htarold/uw-acoustic-modem-dtmf/dtmf-pll.sch.png

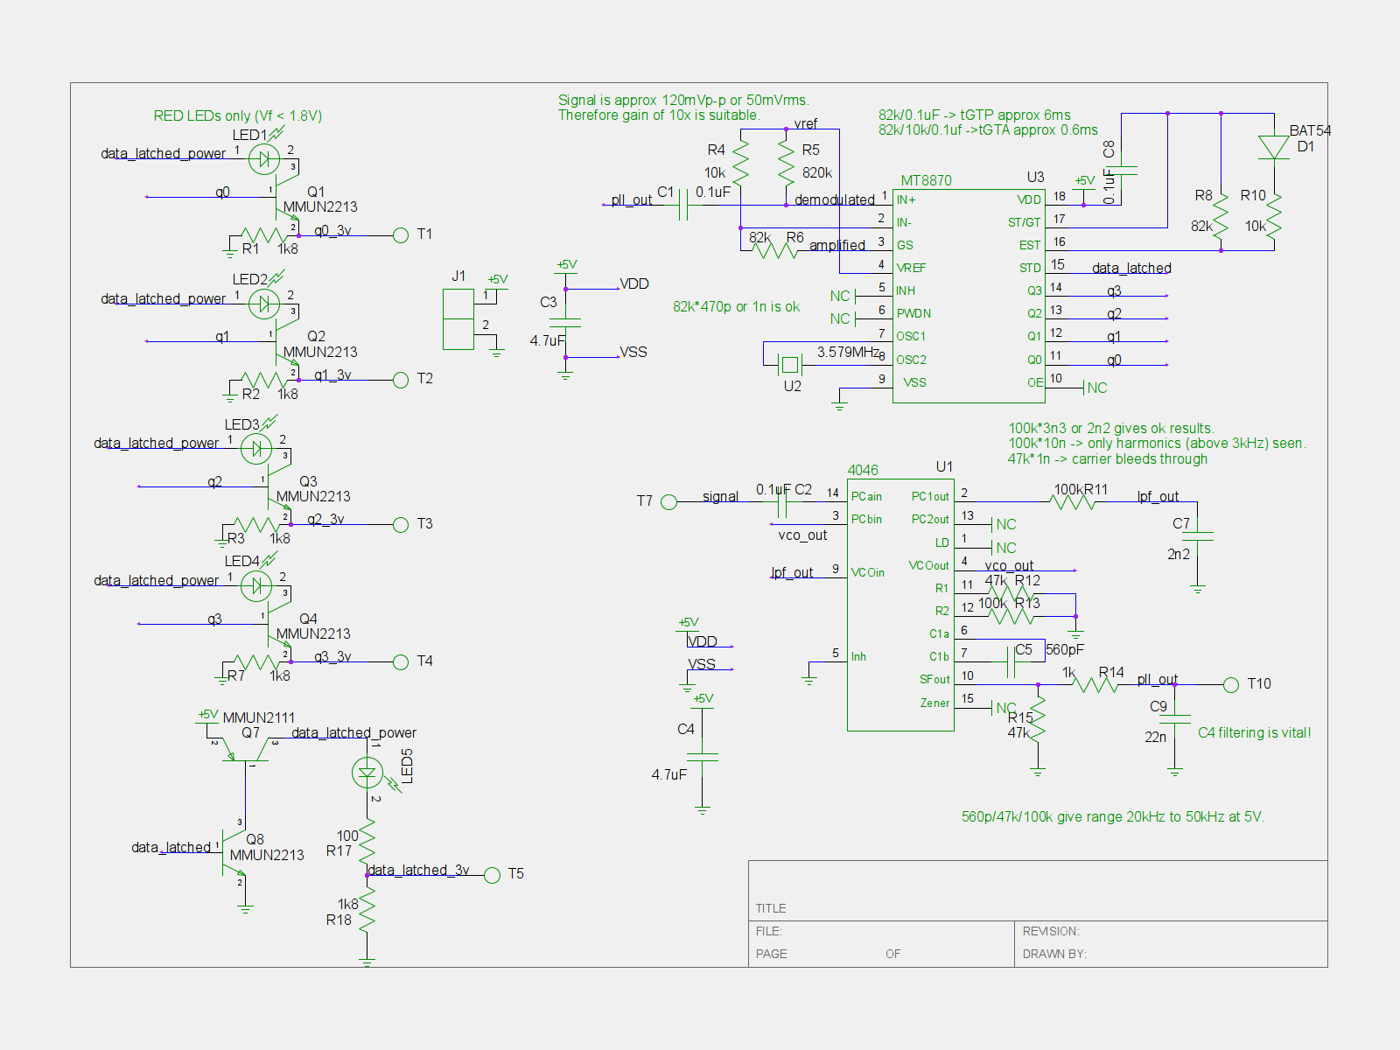
dtmf-pll.sch.png
