htarold/uw-acoustic-modem-dtmf/tx-var.sch.png

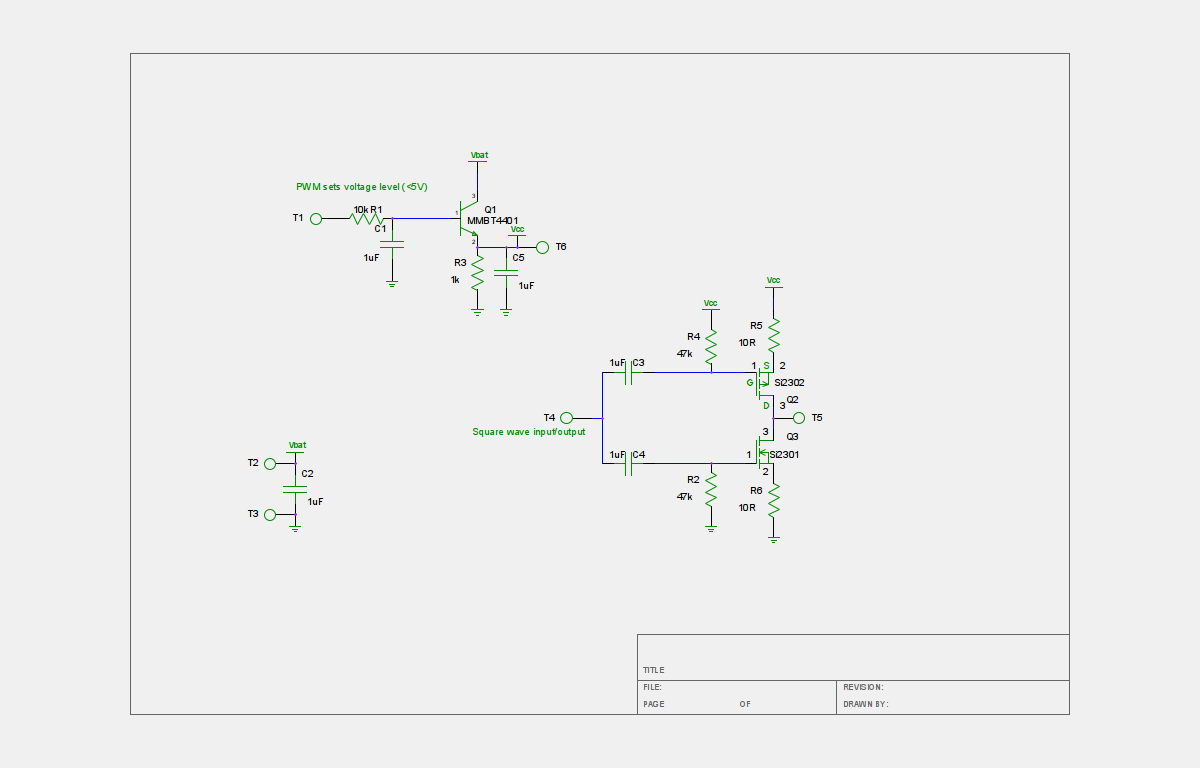
tx-var.sch.png
