htarold/uw-acoustic-modem-dtmf/(list of files, drawings)

Other design files:
dtmf-pll.pcb
tx-var.pcb
